luohuax/Luo-WeatherStation/README.md

# Luo-WeatherStation
基于BMP280和AHT20的微型气象站
基本元件：
中央计算机：STC8H1K08
传感器：BMP280，AHT20
无线电收发机：Si24R1
电源管理：DW06D锂电池放电保护芯片，SGM2028-3.3线性稳压器
特点：
1、内建完整的锂电池放电保护电路
2、完全标定的温度，湿度，气压传感器
3、完全中断式的事件处理系统，允许后台程序长时间占用CPU内核
4、完全硬件控制的数据传输总线
5、为低功耗优化的程控间歇式工作模式
6、气压传感器内置滤波器
7、带有CRC校验的无线电传输
8、返回数据带有电池电压
9、最高10Hz的连续测量
10、小体积且低成本

使用注意事项

发射端：
上电后P3.0和P3.1GPIO口会以115200波特率向外发送传感器的测量值
2.4GHz无线电收发机使用频道75
GPIO定义详见电路图

接收端：
波特率为115200。数据传输格式为：温度，压强，湿度，电池电压（xx.xx,xx.xxx,xx.xx,xx.xx)
