luohuax/Luo-WeatherStation/PCB/Recieve/Recieve_BOM.xlsx

No. | Quantity | Comment | Designator | Footprint | Value | Manufacturer Part | Manufacturer | Supplier Part | Supplier
1 | 3 | 1uF | C2,C4,C16 | C0603 | 1uF
2 | 4 | 100nF | C3,C10,C11,C15 | C0603 | 100nF
3 | 1 | 10nF | C5 | C0603 | 10nF
4 | 1 | 22uF | C9 | C0603 | 22uF
5 | 1 | DS1023-2*4SF11 | H1 | HDR-TH_8P-P2.54-V-F-R2-C4-S2.54-1 |  | DS1023-2*4SF11 | CONNFLY | C92271 | LCSC
6 | 1 |  | H2 | HDR-TH_4P-P2.54-V-M |  |  |  | C492403
7 | 2 |  | LED2,LED4 | LED_0603
8 | 1 | 1K | R2 | R0603 | 1K
9 | 1 |  | SW2 | SW-TH_MSK-12D191P2T
10 | 1 | KH-USB180-AM-4P | U1 | USB-A-SMD_USB-A-1-TH |  | KH-USB180-AM-4P | kinghelm(金航标) | C2828094 | LCSC
11 | 1 | STC8H1K08-36I-QFN20 | U2 | QFN-20_L3.0-W3.0-P0.40-BL-EP1.7 |  | STC8H1K08-36I-QFN20 | STC(宏晶) | C915674 | LCSC
12 | 1 | CH340C | U3 | SOP-16_L10.0-W3.9-P1.27-LS6.0-BL |  | CH340C | WCH(南京沁恒) | C84681 | LCSC
13 | 1 | SGM2028-3.3YN5G/TR | U8 | SOT-23-5_L3.0-W1.7-P0.95-LS2.8-BR |  | SGM2028-3.3YN5G/TR | SGMICRO(圣邦微) | C81088 | LCSC
