luohuax/Luo-WeatherStation/PCB/Send/Send_BOM.xlsx

No. | Quantity | Comment | Designator | Footprint | Value | Manufacturer Part | Manufacturer | Supplier Part | Supplier
1 | 7 | 100nF | C1,C3,C10,C11,C12,C13,C15 | C0603 | 100nF
2 | 3 | 1uF | C2,C4,C16 | C0603 | 1uF
3 | 1 | 10nF | C5 | C0603 | 10nF
4 | 1 | 22uF | C9 | C0603 | 22uF
5 | 1 |  | H1 | HDR-TH_2P-P2.54-V-F |  |  |  | C49661
6 | 1 | 100Ω | R1 | R0603 | 100Ω
7 | 1 | 1K | R2 | R0603 | 1K
8 | 2 | 100K | R20,R21 | R0603 | 100K
9 | 1 |  | SW2 | SW-TH_MSK-12D191P2T
10 | 1 | AHT20 | U1 | SENSOR-SMD_L3.0-W3.0-P1.00-BR |  | AHT20 | 广州奥松 | C2757850 | LCSC
11 | 1 | BMP280 | U2 | WLGA-8_L2.5-W2.0-P0.65-TR_DPS422 |  | BMP280 | Bosch(博世) | C83291 | LCSC
12 | 1 | STC8H1K08-36I-QFN20 | U3 | QFN-20_L3.0-W3.0-P0.40-BL-EP1.7 |  | STC8H1K08-36I-QFN20 | STC(宏晶) | C915674 | LCSC
13 | 1 |  | U4 | G01-SP2(si24r1模块)
14 | 1 | DW06D | U7 | SOT-23-6_L2.9-W1.6-P0.95-LS2.8-BR |  | DW06D | FM(富满) | C82123 | LCSC
15 | 1 | SGM2028-3.3YN5G/TR | U8 | SOT-23-5_L3.0-W1.7-P0.95-LS2.8-BR |  | SGM2028-3.3YN5G/TR | SGMICRO(圣邦微) | C81088 | LCSC
