luohuax/Luo-WeatherStation/(list of files, cad)

Other CAD files:
program/receive/Objects/main.obj
program/send/Objects/main.obj
program/send/Objects/SI24R1.obj
program/receive/Objects/ISP.obj
program/receive/Objects/STARTUP.obj
program/send/Objects/BMP280.obj
program/receive/Objects/SPI.obj
program/send/Objects/SPI.obj
program/receive/Objects/SI24R1.obj
program/send/Objects/ImitateI2C.obj
program/receive/Objects/USART.obj
program/send/Objects/ADC.obj
program/send/Objects/AHT20.obj
program/send/Objects/I2C.obj
