luohuax/Luo-WeatherStation/PCB/Recieve/Recieve_Schemtic.pdf

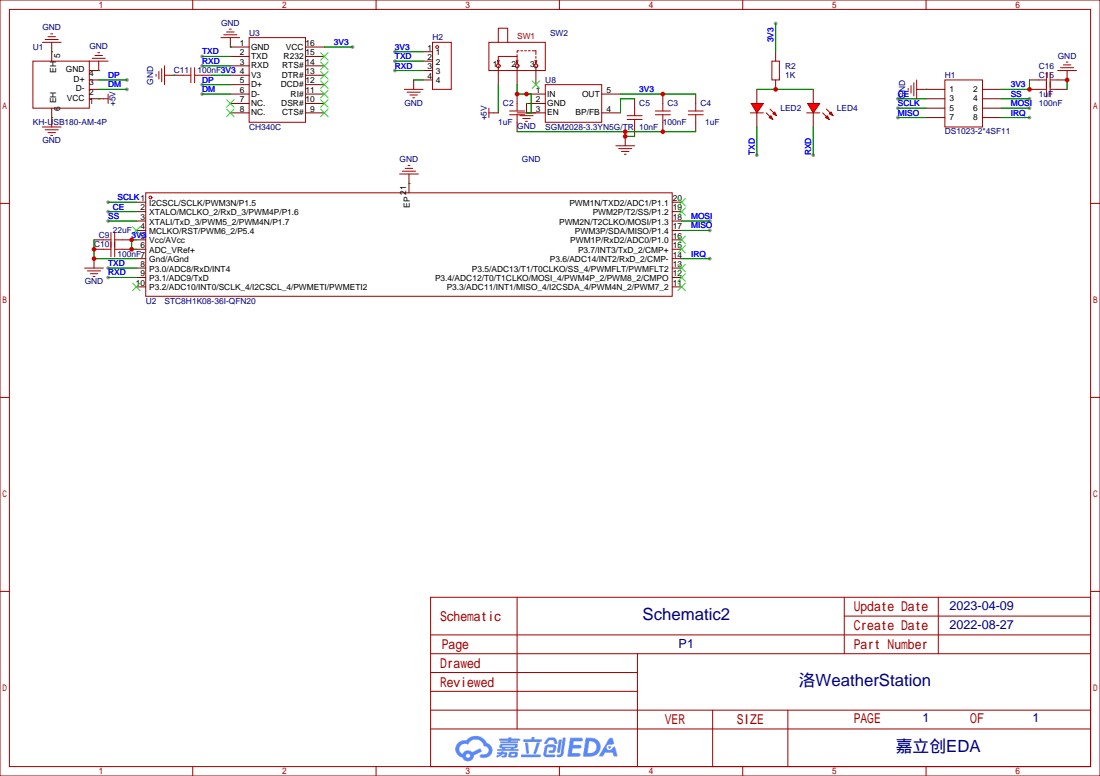
[picture p1: page 1]
