luohuax/Luo-WeatherStation/PCB/Send/Send_Schemtic.pdf

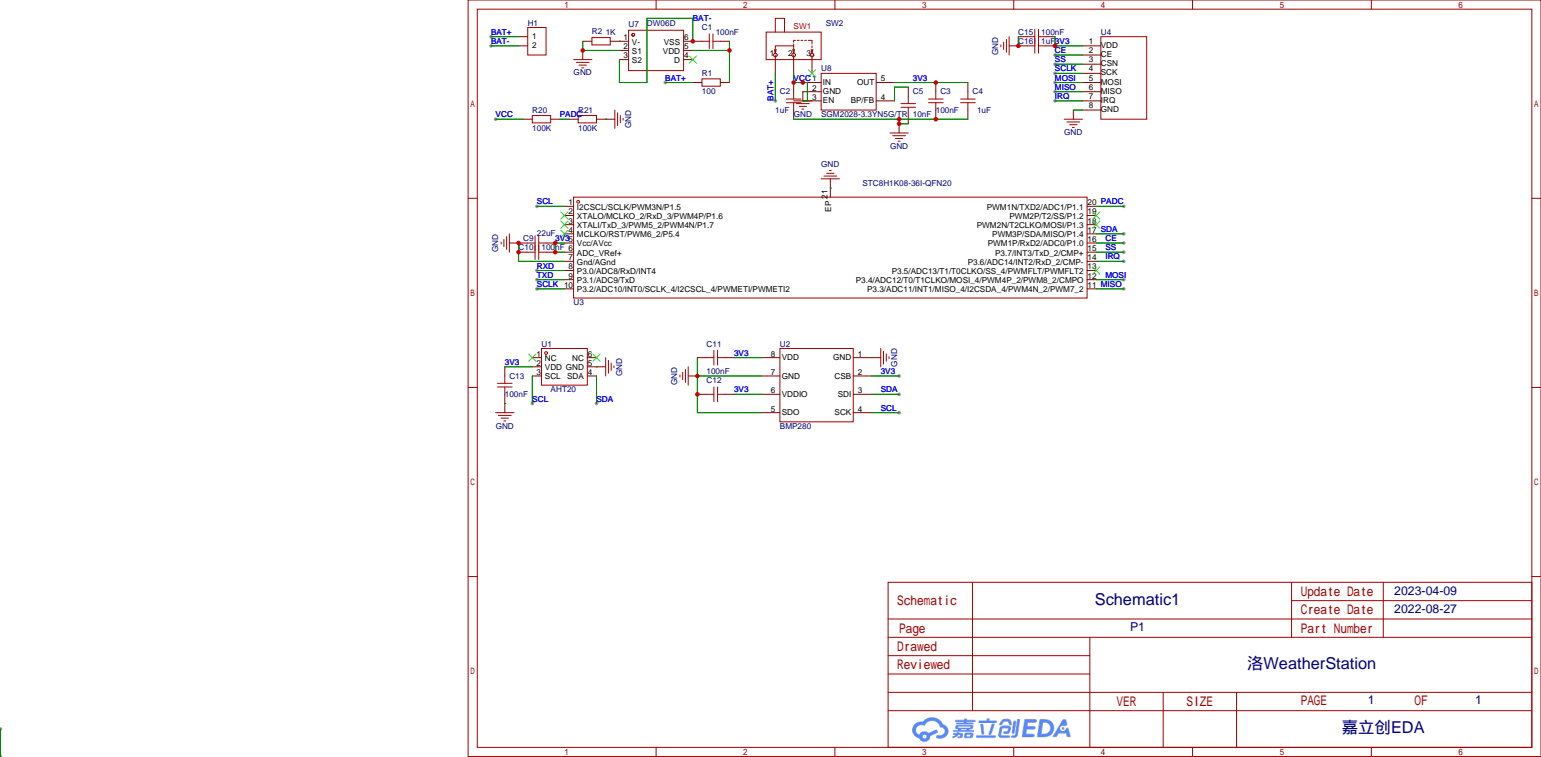
[picture p2: page 1]
